MBfire/hellen-example/boards/uaefi-e/board/misc/uaefi-e-bottom.png

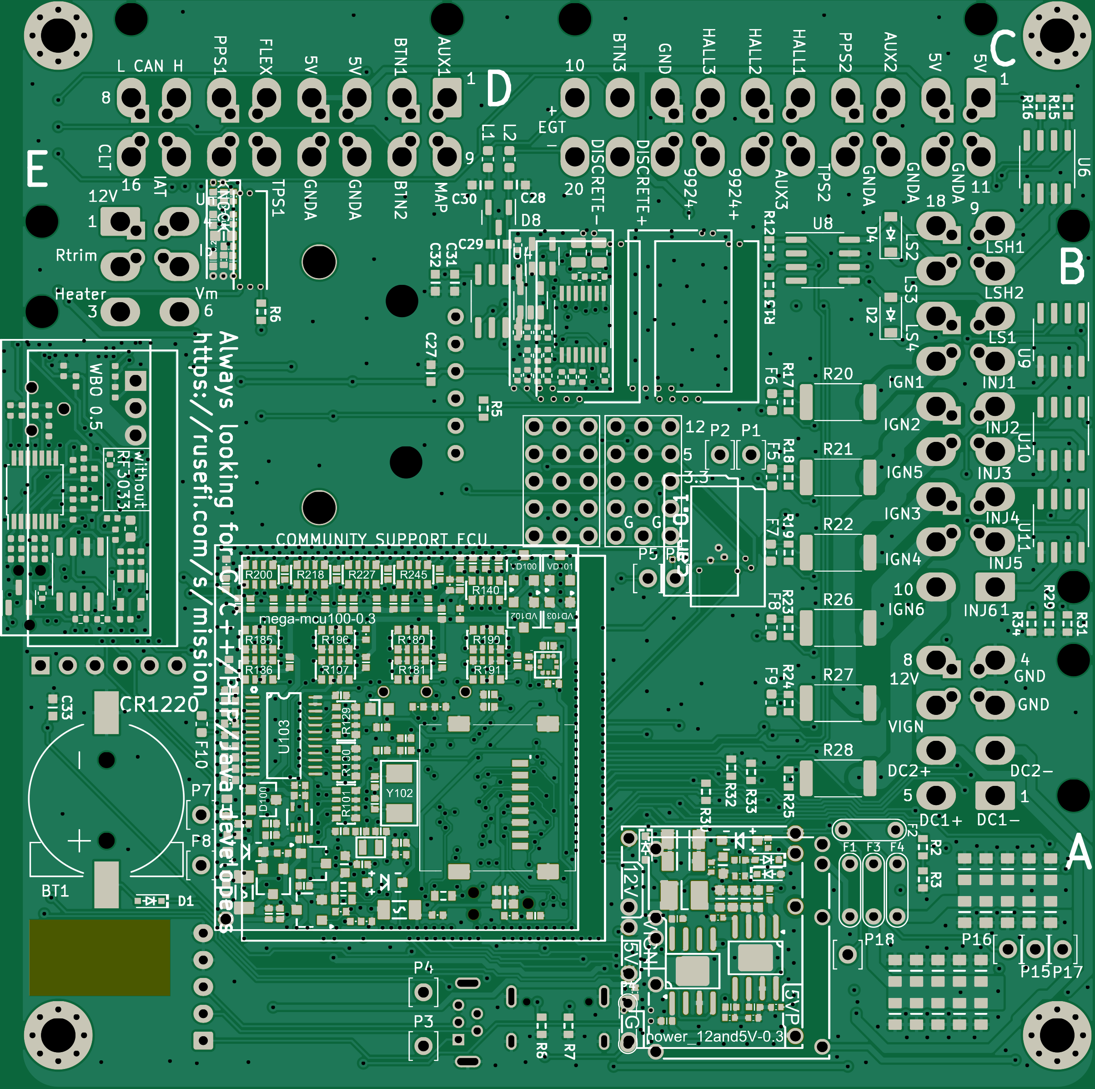
boards/uaefi-e/board/misc/uaefi-e-bottom.png
