MBfire/hellen-example/boards/uaefi-e/board/misc/uaefi-e-outline.png

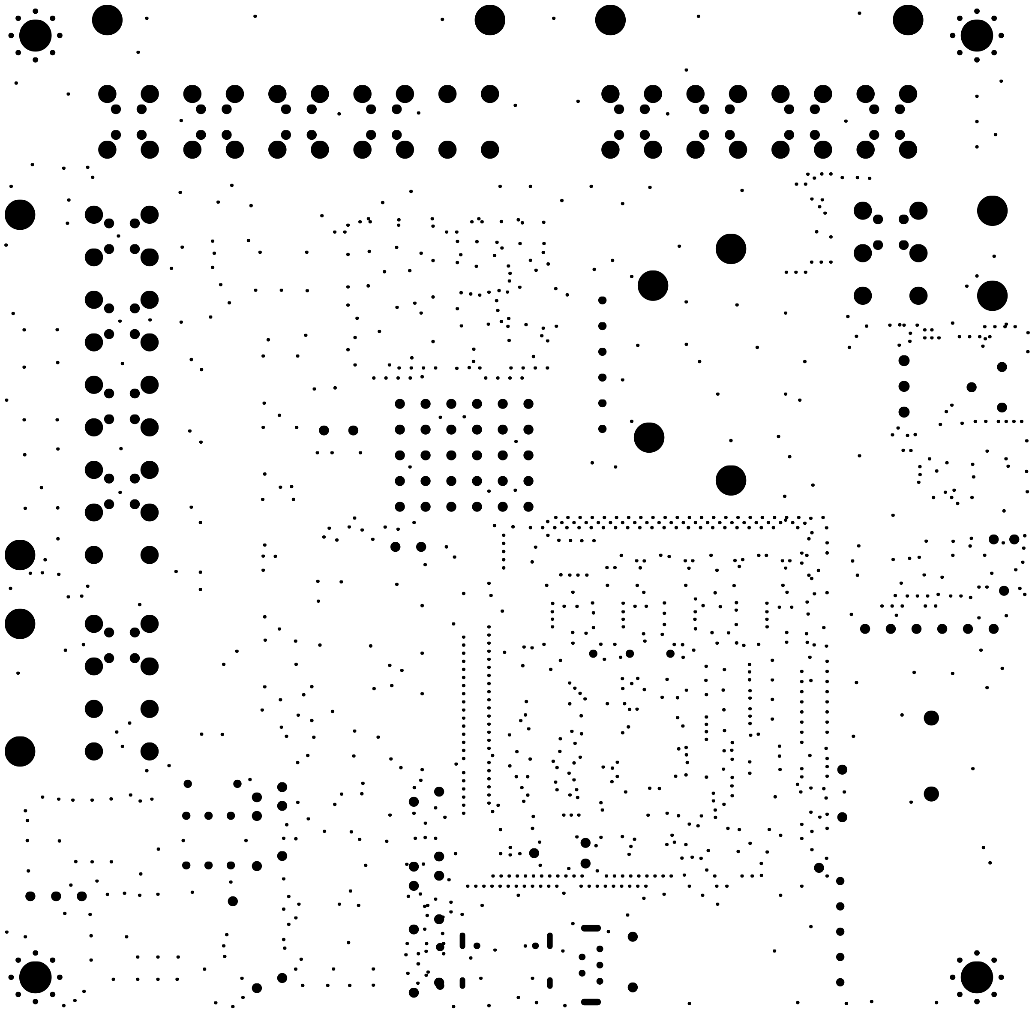
boards/uaefi-e/board/misc/uaefi-e-outline.png
