MBfire/hellen-example/boards/uaefi-e/board/misc/uaefi-e-top.png

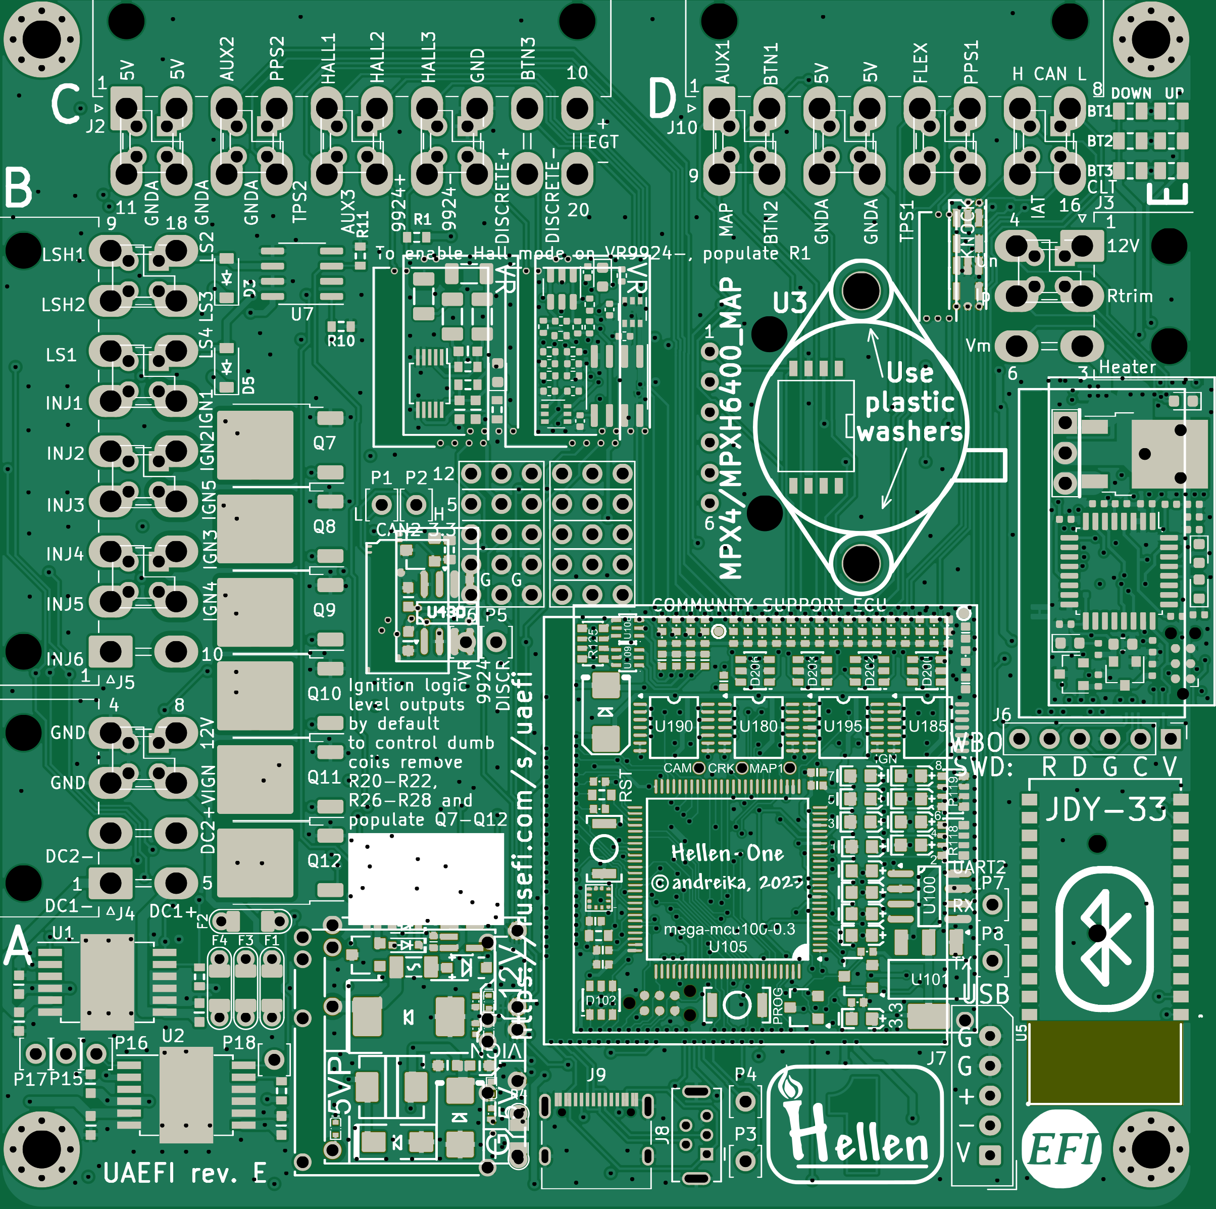
boards/uaefi-e/board/misc/uaefi-e-top.png
