MBfire/hellen-example/boards/uaefi-e/board/uaefi-e.png

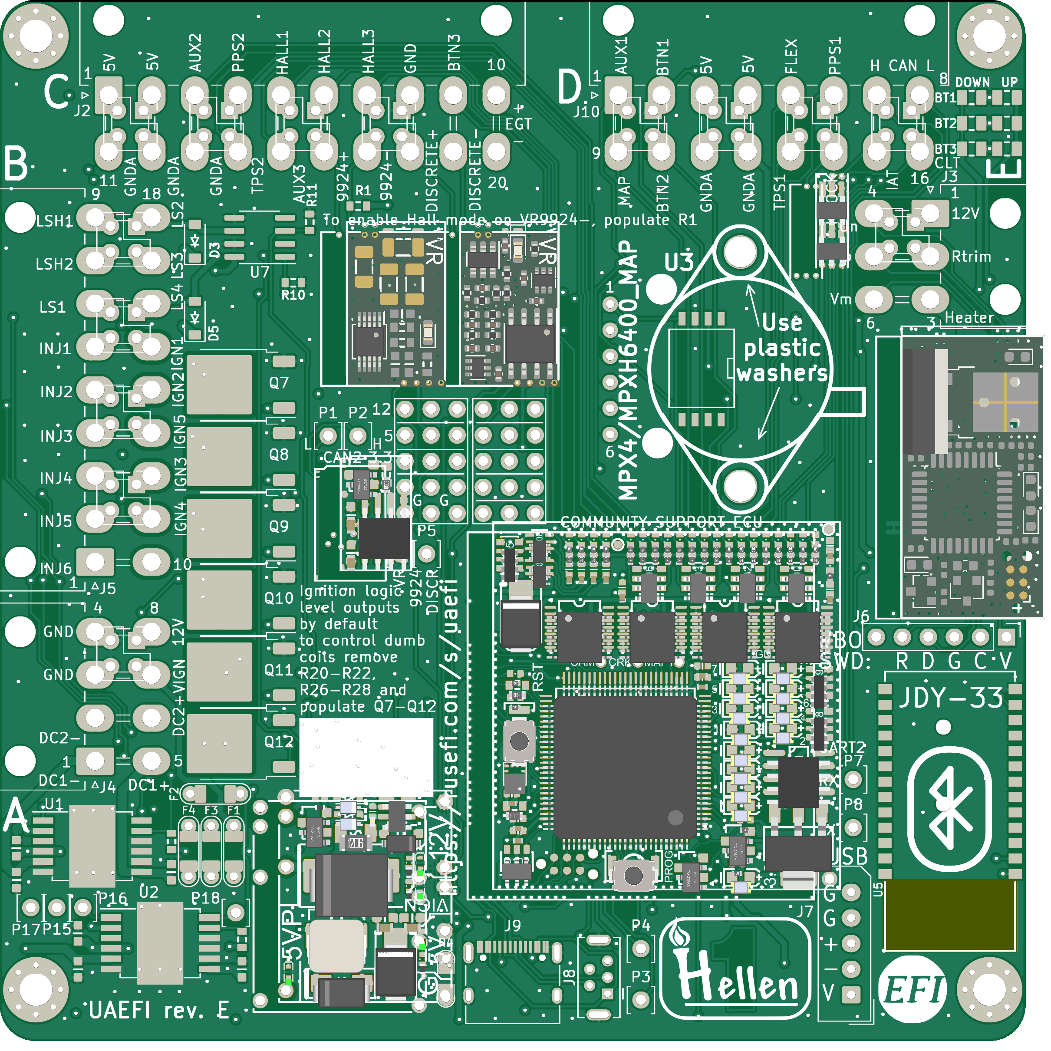
boards/uaefi-e/board/uaefi-e.png
