MBfire/hellen-example/boards/uaefi-e/board/misc/uaefi-e-components.png

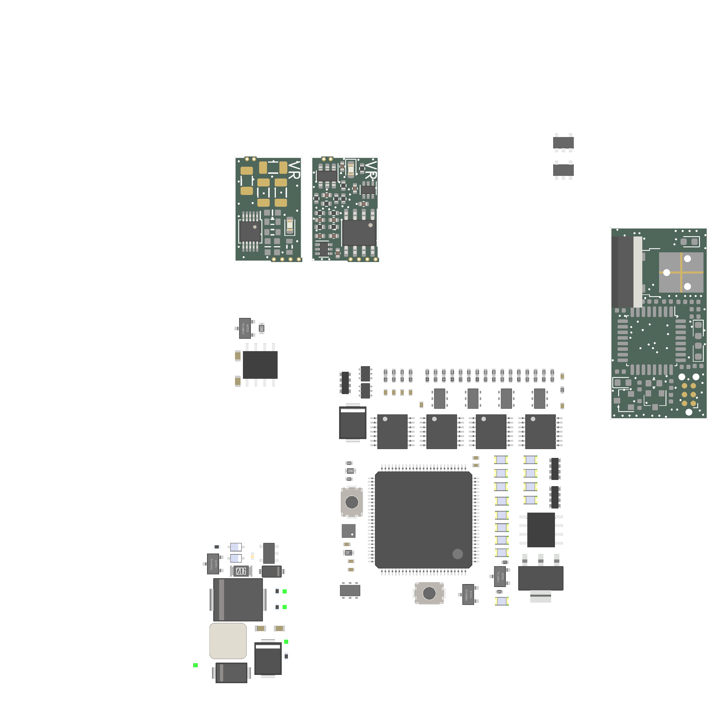
boards/uaefi-e/board/misc/uaefi-e-components.png
