MBfire/hellen-example/(commit log)

2026-02-13 Update BOARD_PREFIX and BOARD_SUFFIX values
2026-02-13 GHA says update kicad6-libraries
2026-02-13 Change BOARD_SUFFIX from 'e' to '-'
2026-02-13 Update BOARD_SUFFIX and BOARD_REVISION values
2026-02-13 Update BOARD_SUFFIX to include '-e'
2026-02-13 Update BOARD_PREFIX, BOARD_SUFFIX, and BOARD_REVISION
2026-02-26 uaefi kicad test added
    [DC_MOTOR_0.1.kicad_sch, IGN6.kicad_sch, INJ6.kicad_sch, LS4.kicad_sch, LS_HOT.kicad_sch, MAP.kicad_sch, egt.kicad_sch, uaefi.kicad_pcb]
2026-02-26 [skip actions] Auto-generated board v2.1
    [uaefi-B_Cu.gbl, uaefi-B_Mask.gbs, uaefi-B_Paste.gbp, uaefi-B_Silkscreen.gbo, uaefi-Edge_Cuts.gm1, uaefi-F_Cu.gtl, uaefi-F_Mask.gts, uaefi-F_Paste.gtp]
